volans/DCMonitor/hardware/DCMonitor.pdf

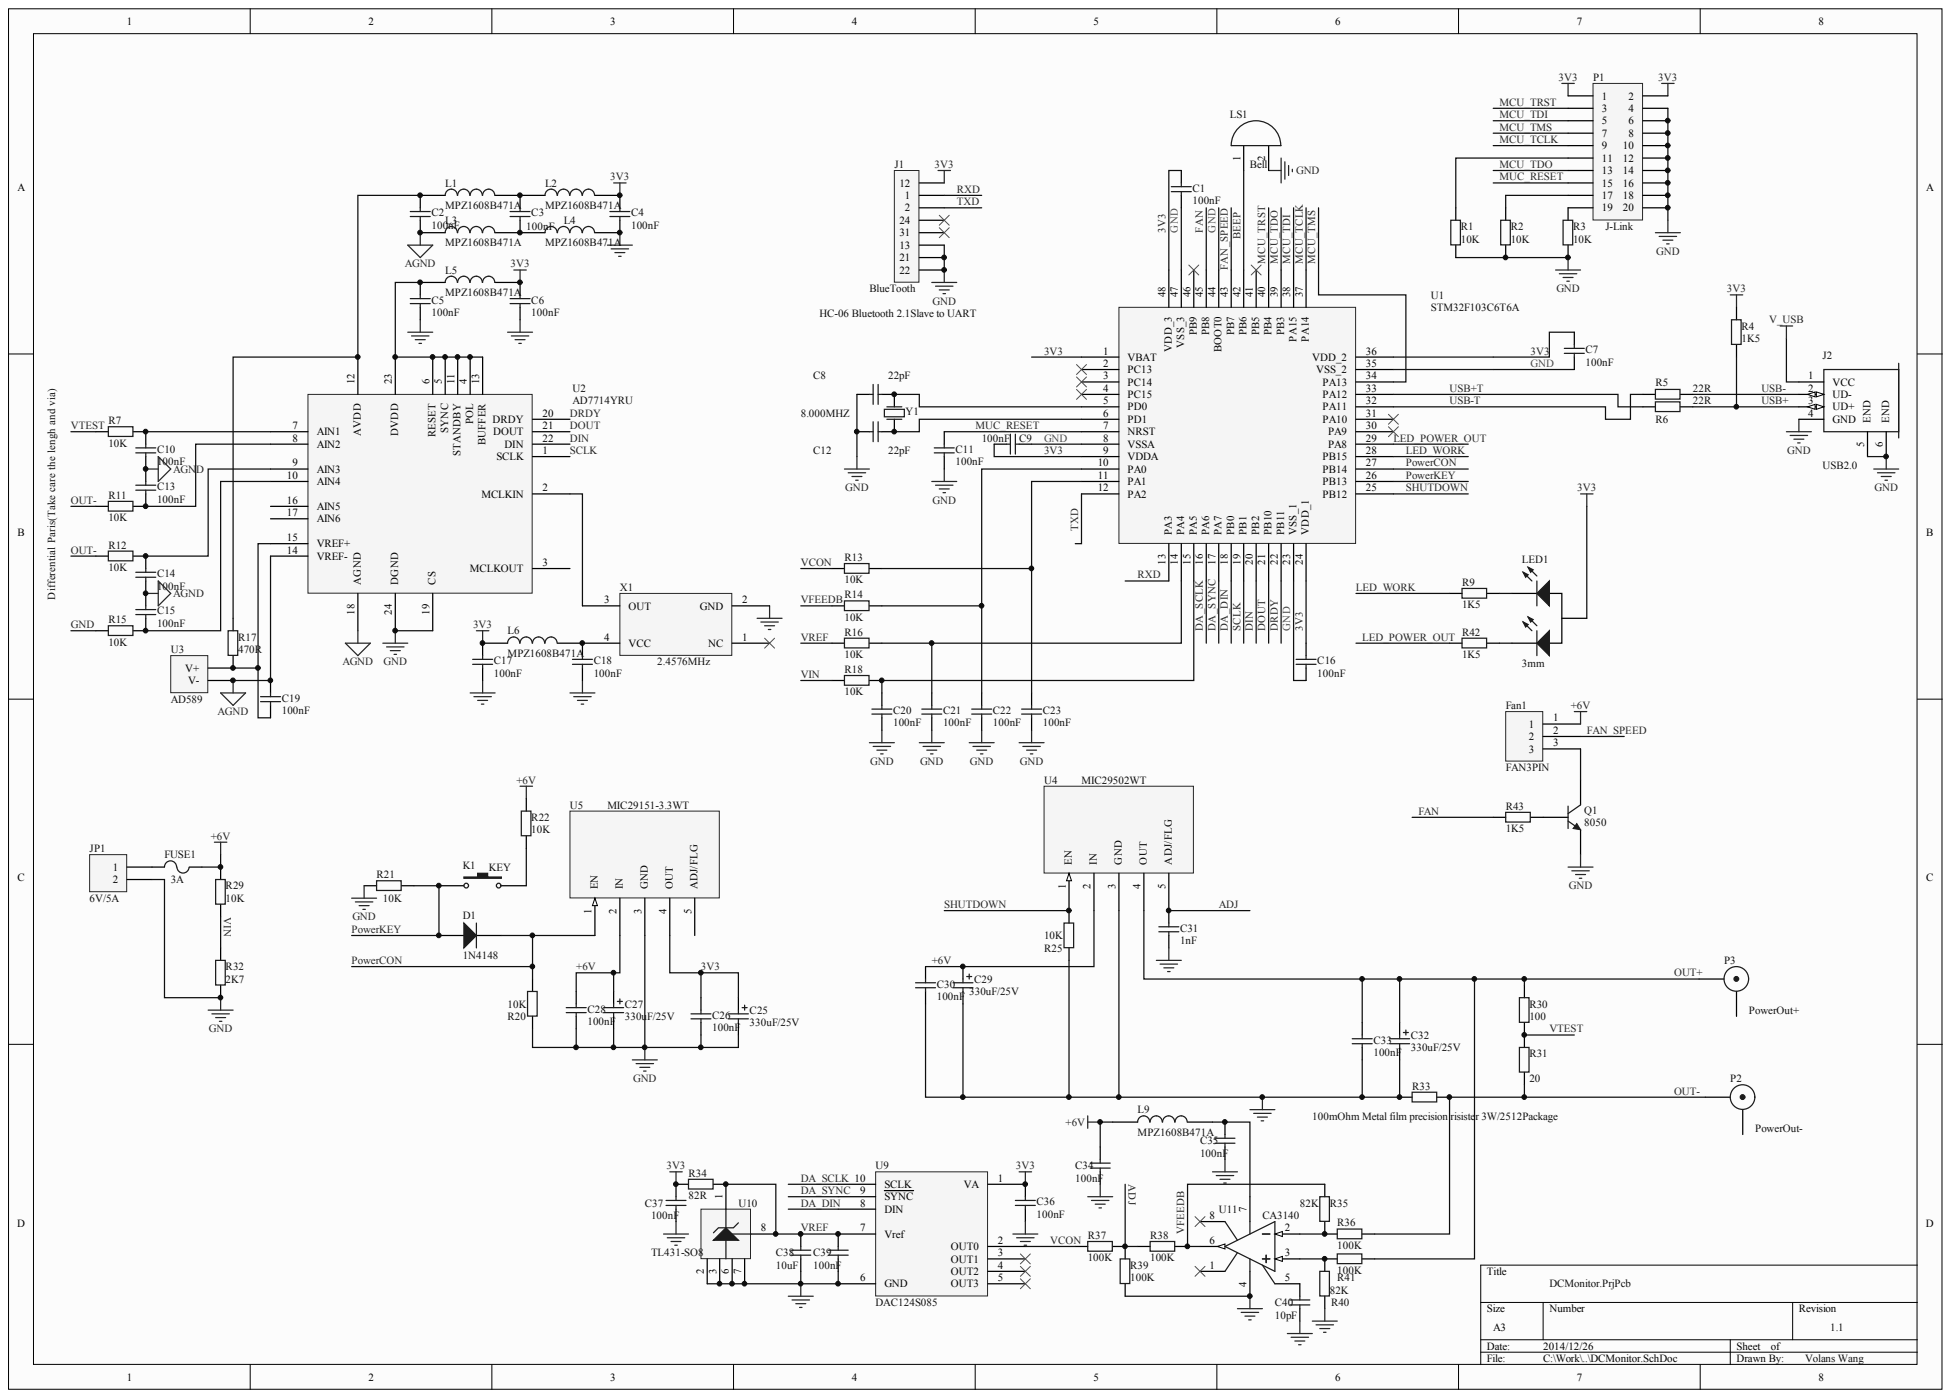
[picture p1: page 1]

MPZ1608B471A C5 100nF

HC-06 Bluetooth 2.1Slave to UART

VBAT 1
PC13 2 | GND

Differential Paris(Take care the lengh and via)

100mOhm Metal film precision risister 3W/2512Package
