volans/DCMonitor/(commit log)

2014-12-29 add STM32 CMSIS library
2014-12-29 add STM32F10x StdPeriph Driver library
2014-12-29 add STM32 FS Device Driver library for USB2.0
2014-12-29 add FreeRTOS configuration include; Add STM32F10x global include file to user code
2014-12-29 Add USB MASS Storage code, all these part was modified from U-DISK sample project of ST. We only use the BULK transport part.
2014-12-29 Add external ADC/DAC driver code.
2014-12-29 add interrupts ISR.
2014-12-29 add two sample tasks and get a try of FreeROTS
2014-12-30 add temperature sensor to internal ADC
